Pavlik/Space-Invaders-mini-console/Models for details/Bottom.step

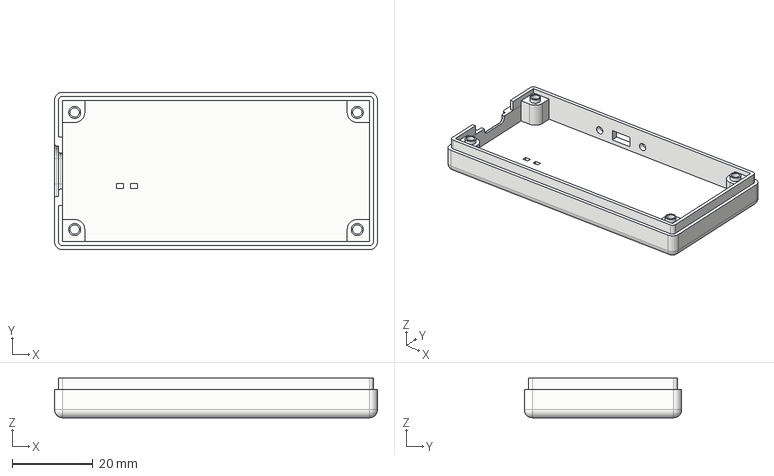
[picture p7: CAD file, 2024-04-07]
Models for details/Bottom.step
80.0 x 39.0 x 9.80 mm
