Pavlik/Space-Invaders-mini-console/Models for details/LightGuide.step

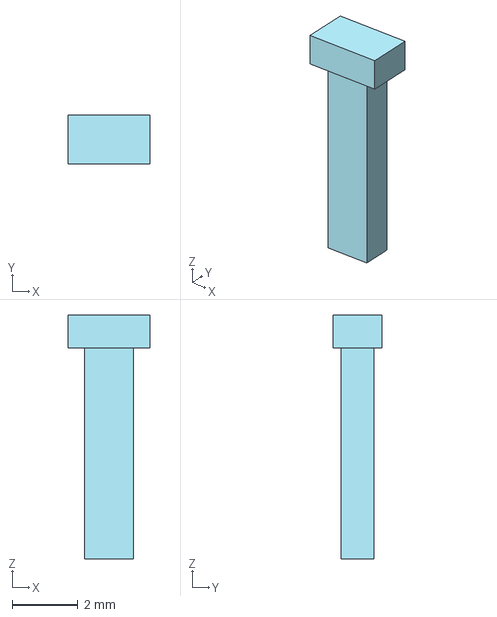
[picture p8: CAD file, 2024-04-07]
Models for details/LightGuide.step
2.50 x 1.50 x 7.40 mm
