Pavlik/Space-Invaders-mini-console/Models for details/Pusher.step

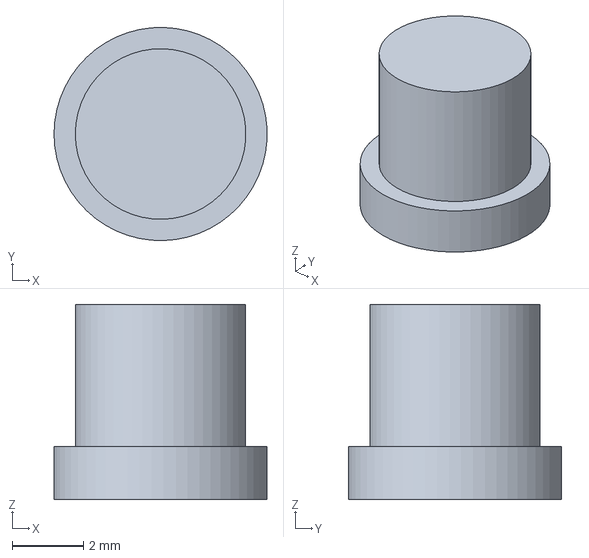
[picture p9: CAD file, 2024-04-07]
Models for details/Pusher.step
6.00 x 6.00 x 5.50 mm
