Pavlik/Space-Invaders-mini-console/Models for details/Top.step

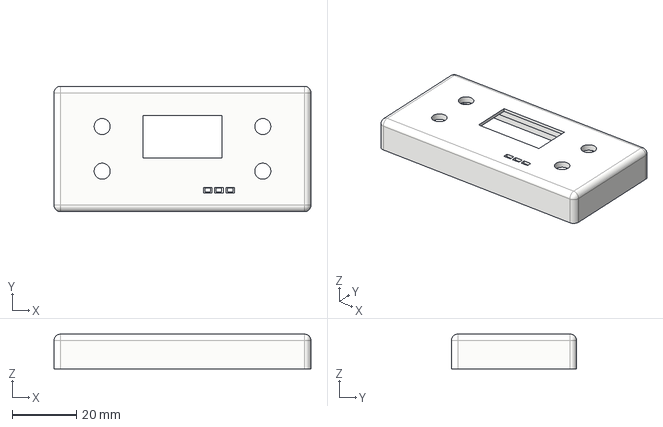
[picture p10: CAD file, 2024-04-07]
Models for details/Top.step
80.0 x 39.0 x 10.8 mm
