Pavlik/Space-Invaders-mini-console/(list of files, cad)

Other CAD files:
Source files for the drawings/Pusher.dwg
Исходники чертежей/Light guide.dwg
Source files for the drawings/Bottom.dwg
Исходники чертежей/Top.dwg
Models for details/LightGuide.ipt
Models for details/Pusher.ipt
Models for details/Top.ipt
Модели/Bottom.ipt
