Pavlik/Space-Invaders-mini-console/Construction documentation/PCB drawing.PDF

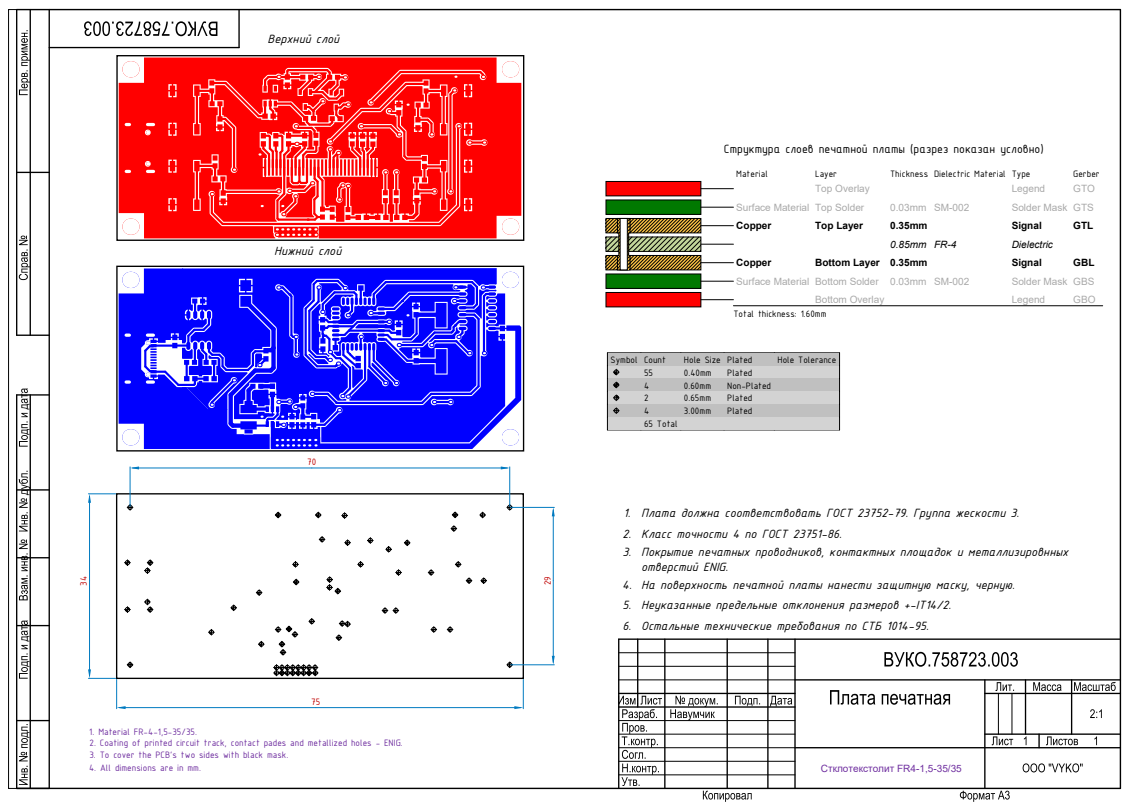
[picture p11: page 1]

Структура слоев печатной платы (разрез показан условно)

Symbol | Count | Hole Size | Plated | Hole Tolerance
55 | 0.40mm | Plated
4 | 0.60mm | Non-Plated
2 | 0.65mm | Plated
4 | 3.00mm | Plated
65 Total

1. Плата должна соответствовать ГОСТ 23752-79. Группа жескости 3.
2. Класс точности 4 по ГОСТ 23751-86.
Покрытие печатных проводников, контактных площадок и металлизировнных
отверстий ENIG.
4. На поверхность печатной платы нанести защитную маску, черную.
5. Неуказанные предельные отклонения размеров +-IT14/2.
6. Остальные технические требования по СТБ 1014-95.

1. Material FR-4-1,5-35/35.
2. Coating of printed circuit track, contact pades and metallized holes - ENIG.
3. To cover the PCB's two sides with black mask.
