Pavlik/Space-Invaders-mini-console/Construction documentation/Assembly drawing of PCB.PDF

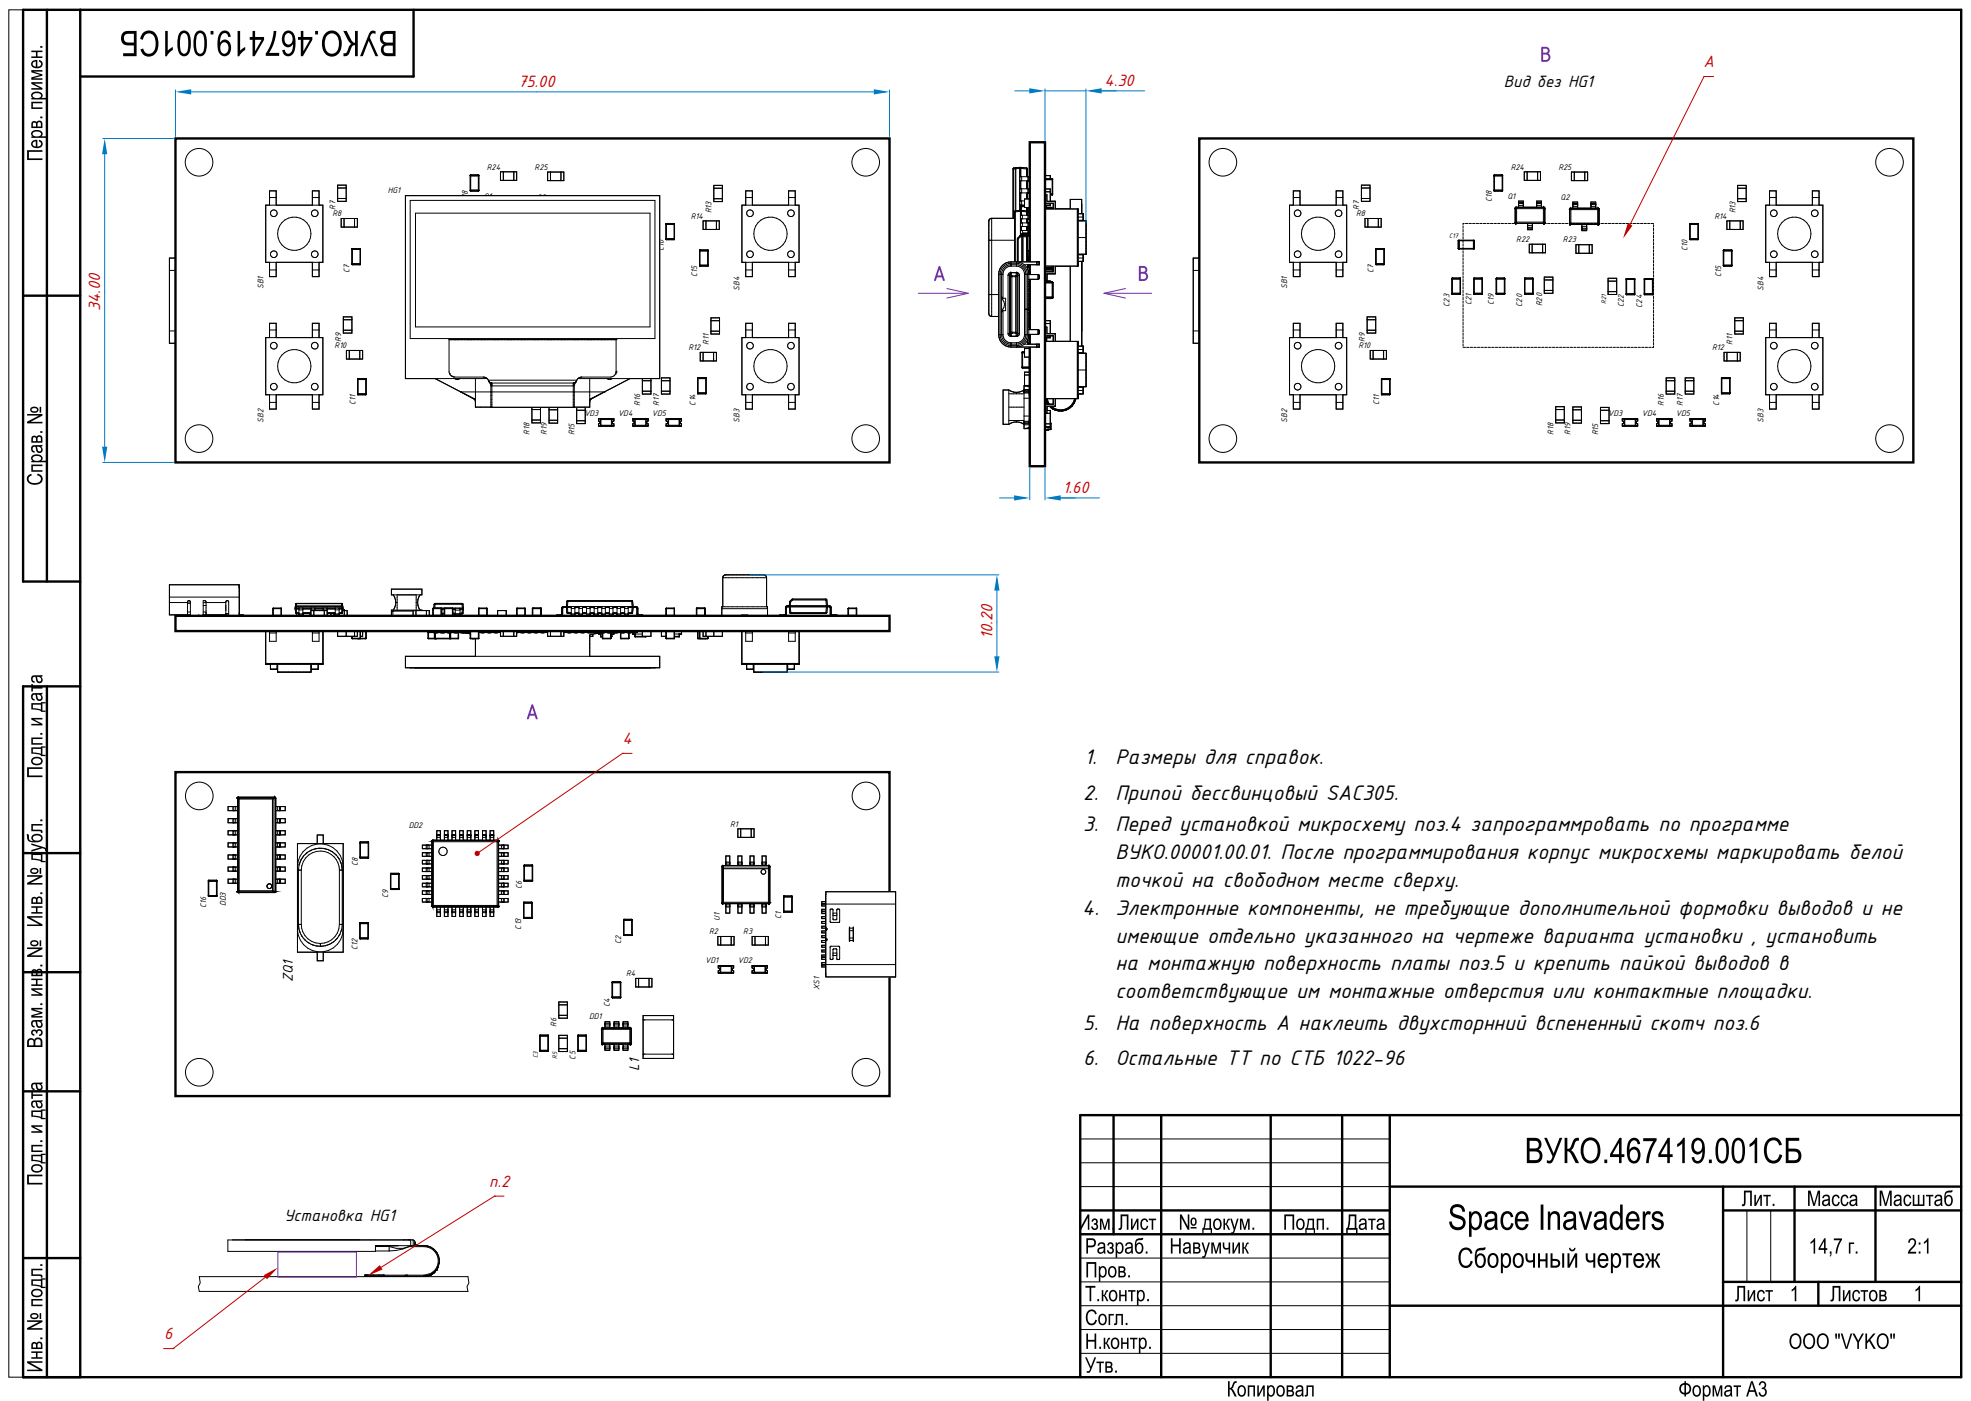
[picture p12: page 1]

1. Размеры для справок.
2. Припой бессвинцовый SAC305.
Перед установкой микросхему поз.4 запрограммровать по программе
ВУКО.00001.00.01. После программирования корпус микросхемы маркировать белой
точкой на свободном месте сверху.
Электронные компоненты, не требующие дополнительной формовки выводов и не
имеющие отдельно указанного на чертеже варианта установки , установить
на монтажную поверхность платы поз.5 и крепить пайкой выводов в
соответствующие им монтажные отверстия или контактные площадки.
5. На поверхность А наклеить двухсторнний вспененный скотч поз.6
6. Остальные ТТ по СТБ 1022-96
