Pavlik/Space-Invaders-mini-console/Construction documentation/Schematics.PDF

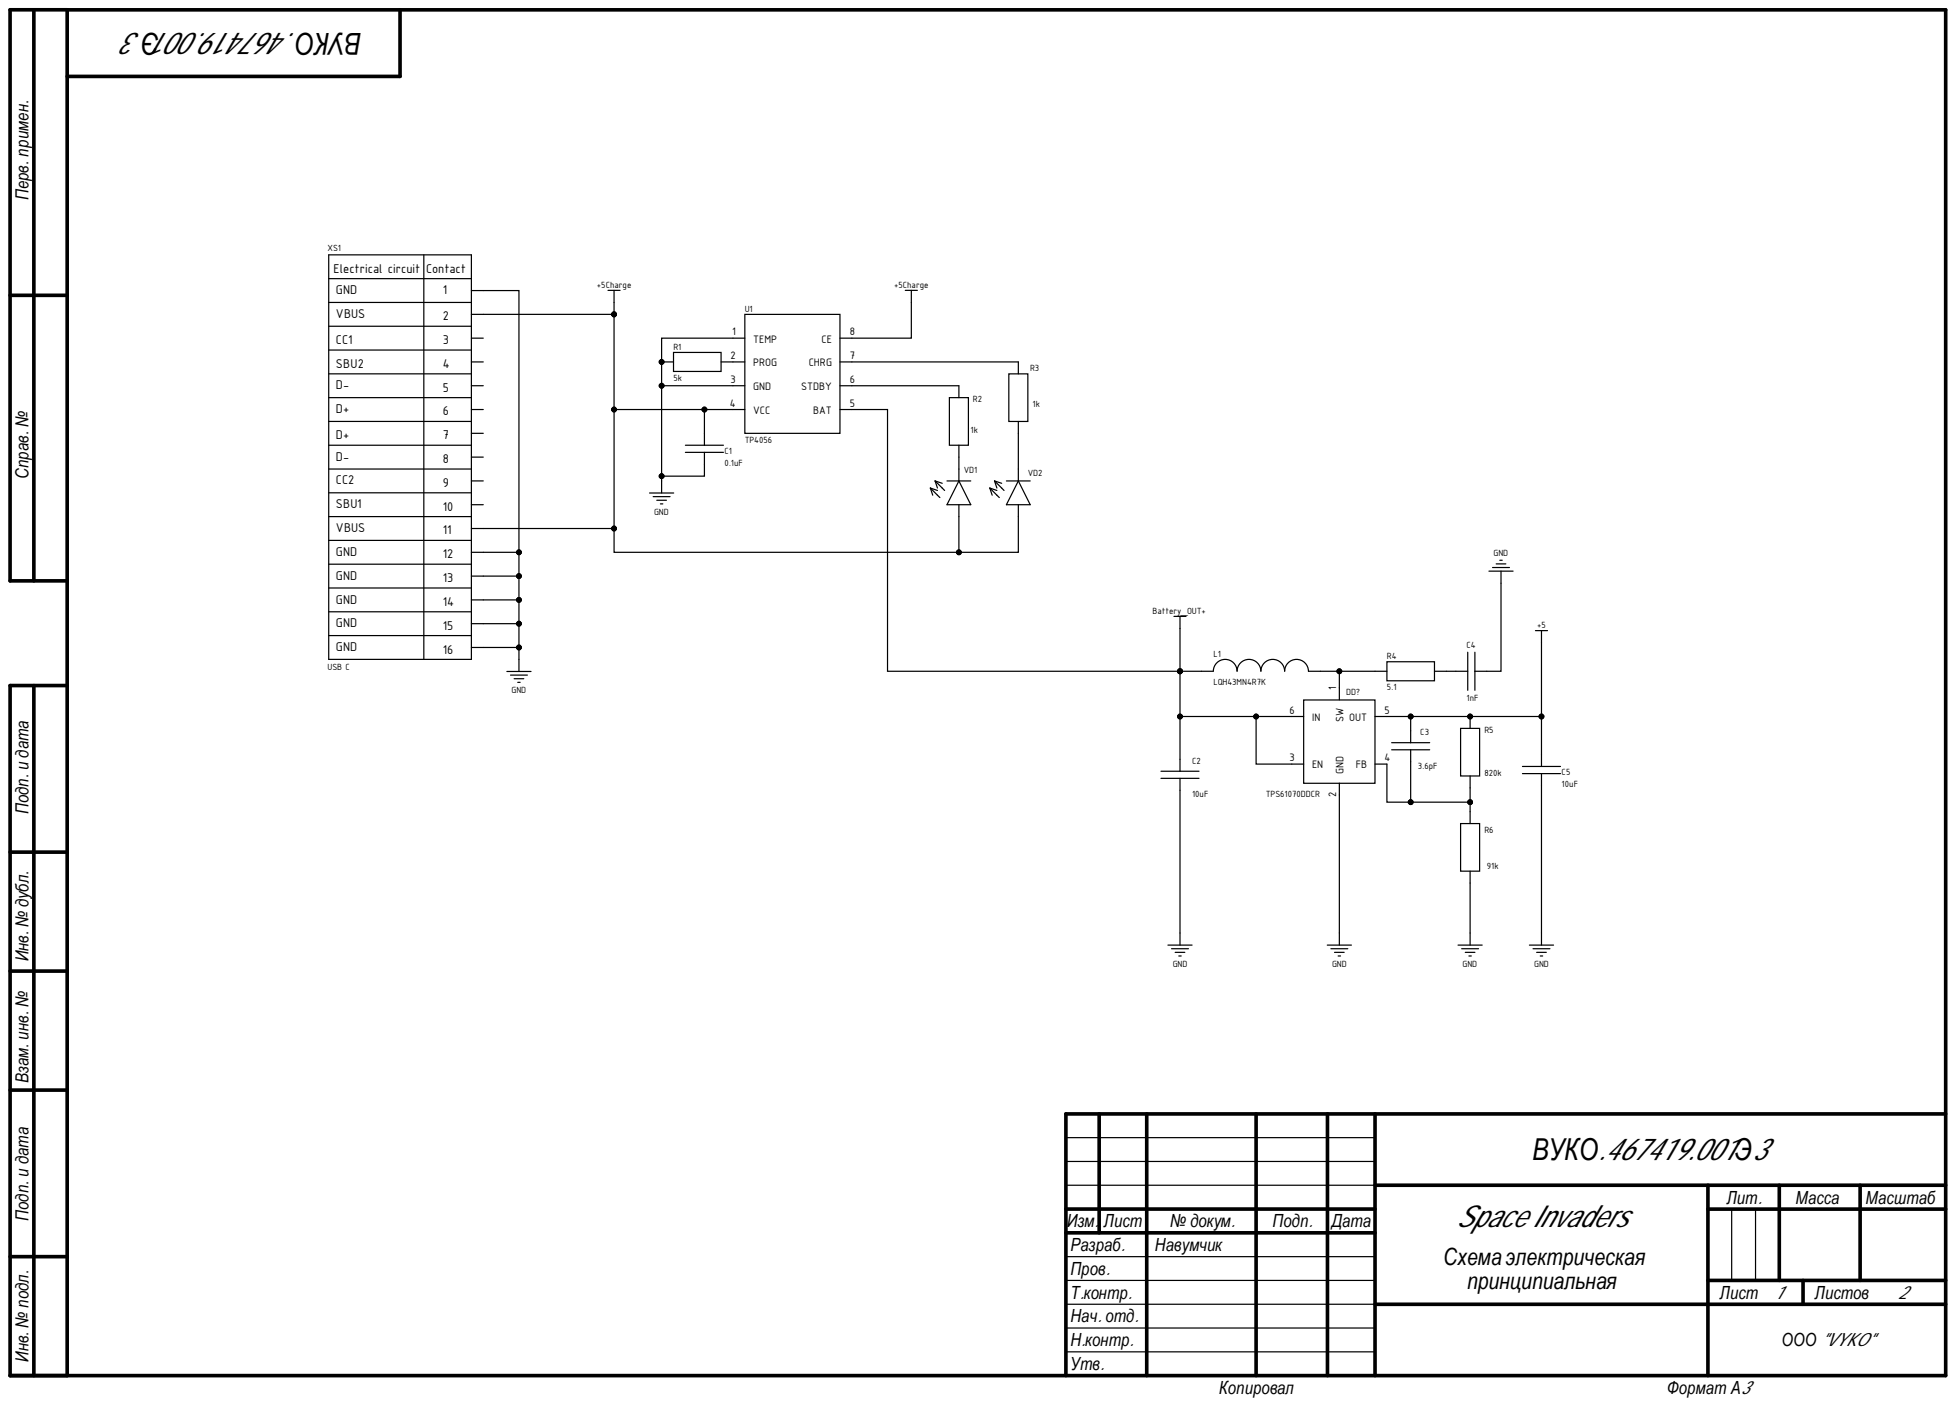
[picture p13: page 1]

Инв. № подл. Инв. № дубл. Подп. и дата Взам. инв. № Подп. и дата Перв. примен. Справ. №

Electrical circui
G N D

t CC1 SBU | Contact 123456789

D +
D -

CC2 SBU

ВУКО.467419.001 Э 3

Space Invaders Схема электрическая принципиаль н ая | Ли т . | Масса | Масшта б

Изм . | Лист | № докум . | Подп . | Да т а
Разр а б . | | Навумчи к
Пр о в .
Т .контр . | | | | | Лист 1 | Листо в 2
На ч. отд . | | | | | ООО "VYKO"
Н .контр .
Утв .

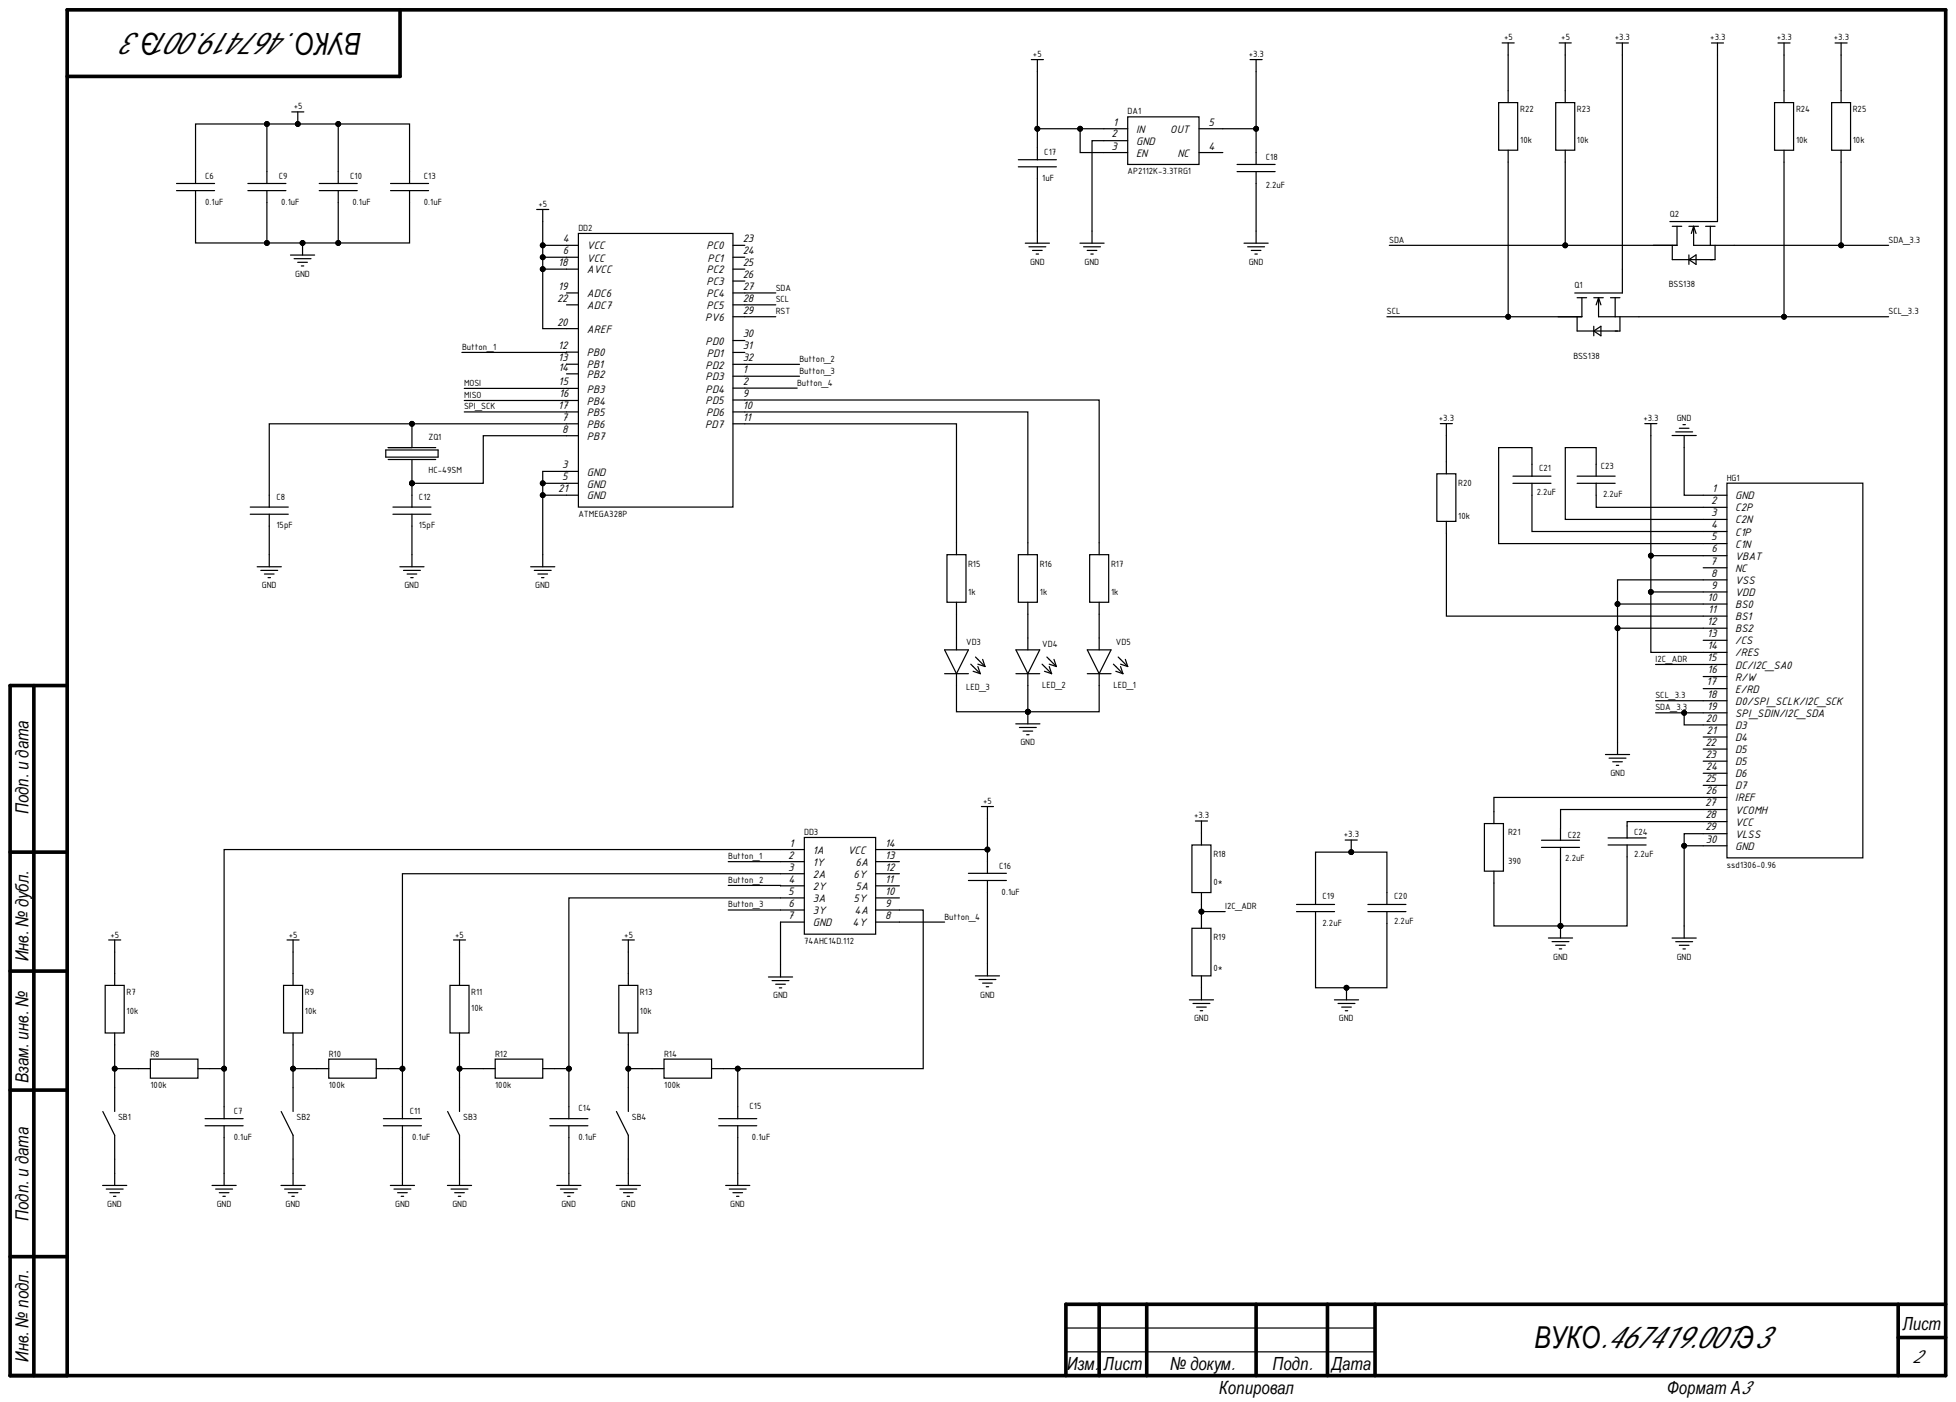
[picture p14: page 2]

1 8
1 9 22 2 | 2

1 0
1 1
12
13

Инв. № подл. Инв. № дубл. Подп. и дата Взам. инв. № Подп. и дата

2 7
2 8

But ton_1 | 2 | | 13

But ton_2 | 4

But ton_3 | 6 | | 9

7 | 3 Y 4 A GND 4 Y | 8

ВУКО.467419.001 Э 3 | Лист 2

Изм . Лист | № докум . | Подп . | Да т а
