Pavlik/Space-Invaders-mini-console/Details/Световод(DLG.001.02).pdf

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

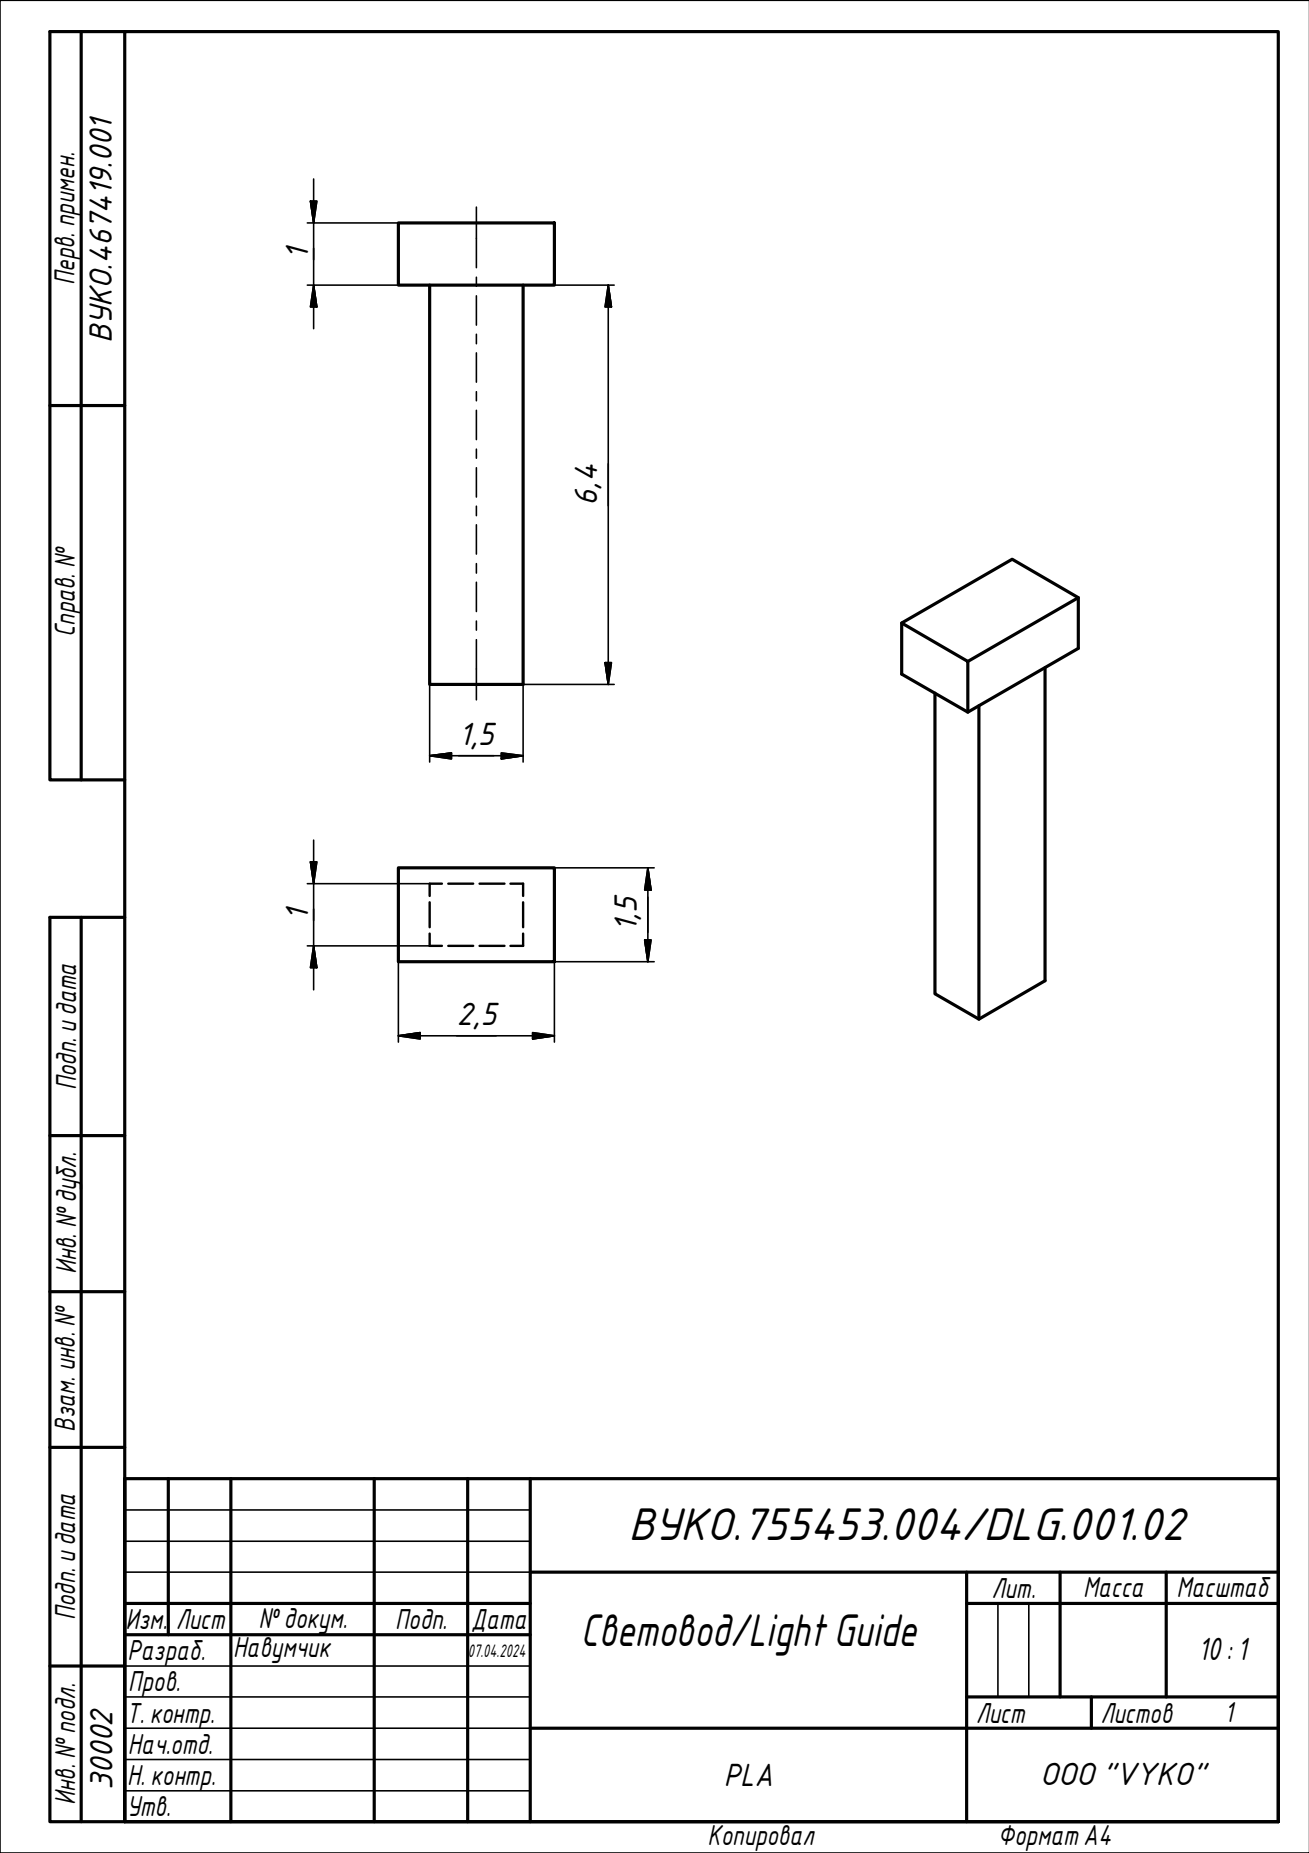
[picture p15: page 1]
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
