Pavlik/Space-Invaders-mini-console/(list of files, drawings)

Other design files:
PCB/ChargeBlock.SchDoc
PCB/ControlBlock.SchDoc
PCB/Footprints.PcbLib
PCB/PCB1.PcbDoc
PCB/PcbLib1.PcbLib
PCB/Schematic.SchLib
PCB/Schlib1.SchLib
PCB/Sheet1.SchLib
PCB/SpaceInvaders.PrjPcb
