Pavlik/Space-Invaders-mini-console/(commit log)

2024-04-07 Add drawings of 4 parts, add dwg files and 3d models
    [Bottom.dwg, DLG.001.01.dwg, DP.001.01.dwg, LightGuide.ipt, LightGuide.step, Pusher.ipt, Pusher.step, Top.dwg]
2024-04-07 add 3d models of bottom part, change name of origin drawings
    [Bottom.ipt, Bottom.step, Light guide.dwg, Pusher.dwg]
2026-10-11 add gitignore. add pcb project
